micheledinelli/cam-ino/3d-case/hunter-case-v2.stl

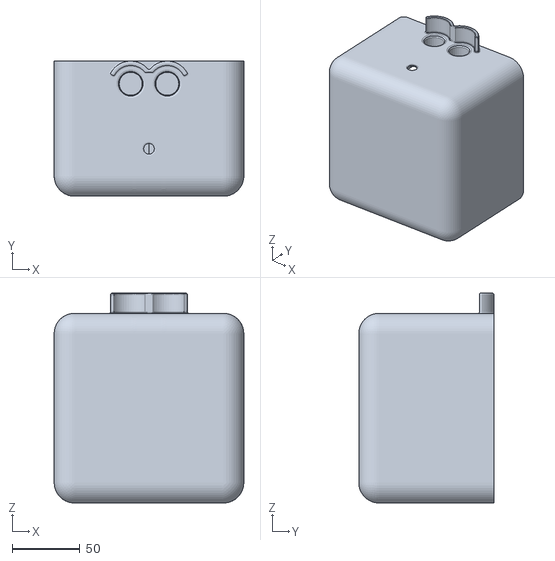
[picture p14: CAD file, 2025-10-02]
3d-case/hunter-case-v2.stl
140.0 x 100.0 x 155.0
