micheledinelli/cam-ino/(commit log)

2025-09-11 feat: add working main file for ultrasonic sensor and temperature
2025-09-22 feat: add esp32cam code
2025-09-22 chore: remove directory arduino
2025-09-22 feat(3d-printer): add 3d files
2025-09-22 feat(esp32cam): update esp32cam.ino
2025-10-02 feat(3d): add hunter-case-v2.stl
    [hunter-case-v2.stl]
2025-10-12 feat(arduino-uno): parametrize trigger distance
2025-10-19 feat: increase debounce in esp32cam.ino and improve image quality
2025-11-03 feat(arduino-uno): update trigger distance
